rmdcarney/QuIPS_SiPM_Yale/SiPM_board_draft.kicad_pcb

## KiCad design SiPM_board_draft.kicad_pcb (2025-09-12)

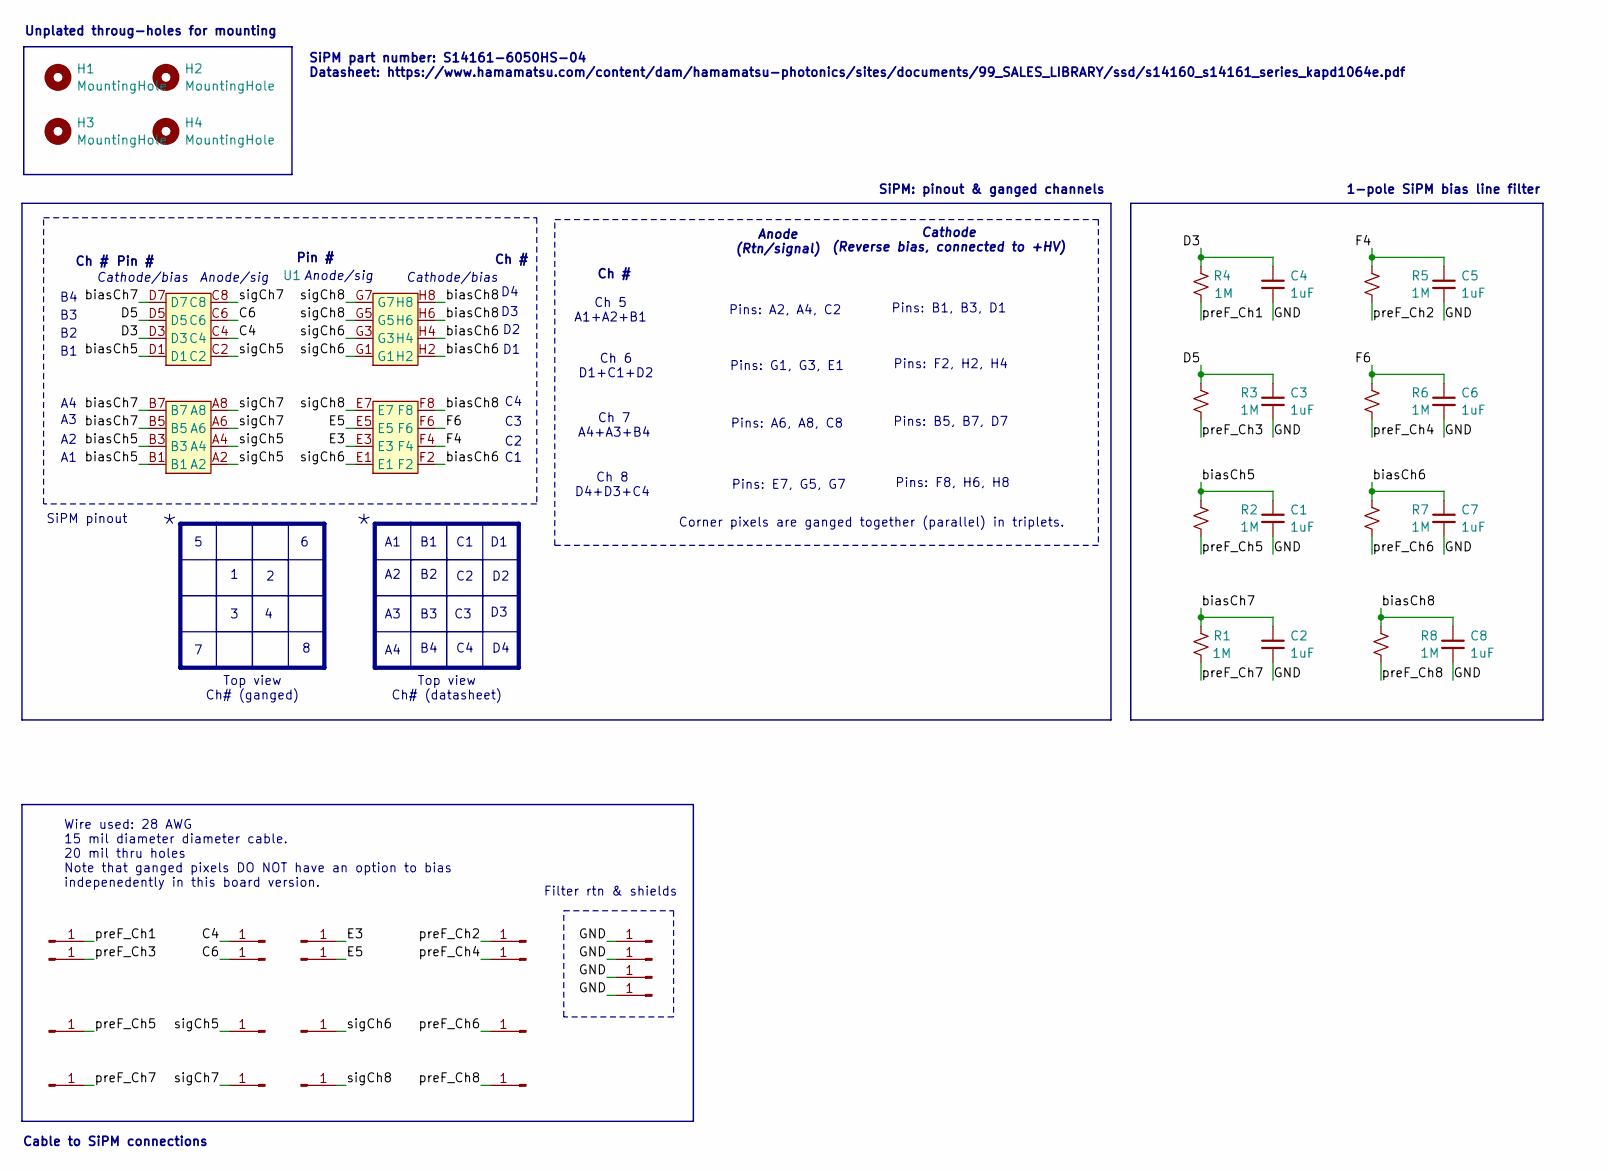
[picture p1: schematic SiPM_board_draft.kicad_sch, QuIPS SiPM breakout board]

Parts:
C1, C2, C3, C4, C5, C6, C7, C8: 1uF; C_0805_2012Metric
H1, H2, H3, H4: MountingHole; MountingHole_3.5mm
J1, J2, J3, J4, J5, J7, J8, J10, J11, J12, J13, J16, J18, J19, J21, J24, J26, J27, J29, J32: Conn_01x01_Pin; SolderWire-0.15sqmm_1x01_D0.5mm_OD1.5mm
R1, R2, R3, R4, R5, R6, R7, R8: 1M; R_0402_1005Metric
U1: S14161-6050HS-04_landing

Connections:
/C4: J19.1, U1.C4
/C6: J18.1, U1.C6
/D3: C4.1, R4.1, U1.D3
/D5: C3.1, R3.1, U1.D5
/E3: J10.1, U1.E3
/E5: J11.1, U1.E5
/F4: C5.1, R5.1, U1.F4
/F6: C6.1, R6.1, U1.F6
/GND: C1.2, C2.2, C3.2, C4.2, C5.2, C6.2, C7.2, C8.2, J1.1, J4.1, J7.1, J12.1
/biasCh5: C1.1, R2.1, U1.B1, U1.B3, U1.D1
/biasCh6: C7.1, R7.1, U1.F2, U1.H2, U1.H4
/biasCh7: C2.1, R1.1, U1.B5, U1.B7, U1.D7
/biasCh8: C8.1, R8.1, U1.F8, U1.H6, U1.H8
/preF_Ch1: J2.1, R4.2
/preF_Ch2: J27.1, R5.2
/preF_Ch3: J3.1, R3.2
/preF_Ch4: J26.1, R6.2
/preF_Ch5: J5.1, R2.2
/preF_Ch6: J32.1, R7.2
/preF_Ch7: J8.1, R1.2
/preF_Ch8: J29.1, R8.2
/sigCh5: J24.1, U1.A2, U1.A4, U1.C2
/sigCh6: J13.1, U1.E1, U1.G1, U1.G3
/sigCh7: J21.1, U1.A6, U1.A8, U1.C8
/sigCh8: J16.1, U1.E7, U1.G5, U1.G7

Notes on the sheet:
Top view Ch# (datasheet)
Pins: G1, G3, E1
Cable to SiPM connections
Pins: A6, A8, C8
Anode (Rtn/signal)
Anode/sig
Cathode (Reverse bias, connected to +HV)
Pins: F8, H6, H8
Ch #
1-pole SiPM bias line filter
Pins: B5, B7, D7
Unplated throug-holes for mounting
Pins: A2, A4, C2
Corner pixels are ganged together (parallel) in triplets.
Cathode/bias
SiPM part number: S14161-6050HS-04 Datasheet: https://www.hamamatsu.com/content/dam/hamamatsu-photonics/sites/documents/99_SALES_LIBRARY/ssd/s14160_s14161_series_kapd1064e.pdf
Ch 5 A1+A2+B1
Wire used: 28 AWG 15 mil diameter diameter cable. 20 mil thru holes Note that ganged pixels DO NOT have an option to bias indepenedently in this board version.
Pin #
Ch 6 D1+C1+D2
SiPM pinout
Pins: F2, H2, H4
Pins: B1, B3, D1
Ch 8 D4+D3+C4
SiPM: pinout & ganged channels
Top view Ch# (ganged)
Ch 7 A4+A3+B4
Filter rtn & shields
Pins: E7, G5, G7

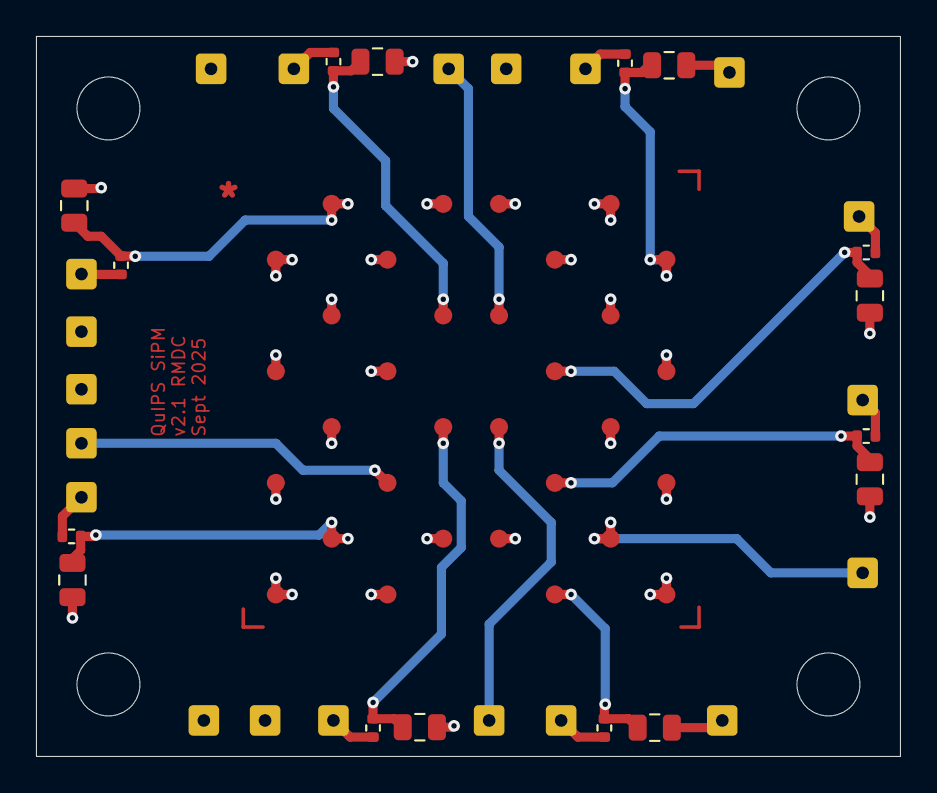
[picture p2: board SiPM_board_draft.kicad_pcb from above]

Board: 4 copper layers, 48.0 x 40.0 mm, 41 parts (0 on the bottom side), 25 nets.
