rmdcarney/QuIPS_SiPM_Yale/(commit log)

2025-07-14 First floorplan, no traces, vias
    [SiPM_board_draft.kicad_pcb, SiPM_board_draft.kicad_sch]
2025-07-16 V1.0 submitted for fab
    [SiPM_board_draft.kicad_sch]
2025-07-16 V1.1 - Added 0.7 mm clearance to all nets just to make sure there's no breakdowns.
2025-08-07 Fabricated version 1.
    [SiPM_board_draft.kicad_pcb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]
2025-09-04 First draft of schematic for RC variant of board complete. Started placing with 0402 resistors and 1210 caps. Caps are really big. See if I can go smaller?
    [SiPM_board_draft.kicad_pcb, SiPM_board_draft.kicad_sch]
2025-09-09 Rough placement.
    [SiPM_board_draft.kicad_pcb, SiPM_board_draft.kicad_sch]
2025-09-10 Branching here to make a shared ground.
    [SiPM_board_draft.kicad_pcb]
2025-09-11 Changed everything to a common ground. Got rid of the jumpers and just made common nets. Reduced the number of ground lines on the board to 4. Everything placed. Going to try routing.
    [SiPM_board_draft.kicad_pcb, SiPM_board_draft.kicad_sch]
2025-09-11 First draft of full layout with hard-ganged parallel channels, 4 layer, common ground.
    [SiPM_board_draft.kicad_pcb, SiPM_board_draft.kicad_sch]
2025-09-12 First draft of board v2.1. Made caps all 0806, should be good for either 4.7uF at 50V or 2.2uF at 100V. Either way, sufficient for this application. This was done to decrease the vertical footprint o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
    [SiPM_board_draft.kicad_pcb, SiPM_board_draft.kicad_sch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]
